Medialoco/sismo-la/docs/hackster-submission.md

# Hackster submission checklist (to stay within the rules)

**Published project:**  
https://www.hackster.io/thepriben/sismo-la-the-seismograph-that-learns-from-real-quakes-545685  
(11 September 2026 — Story, schematic, Things; contest submit still due **13 Sep 2026**.)

Summary of the rules to follow, based on the
[Content Guidelines](https://www.hackster.io/guidelines) and
[How to Create a High-Quality Project Tutorial](https://www.hackster.io/AlexWulff/how-to-create-a-high-quality-project-tutorial-e25feb).
We fill this page in as the project progresses.

## Contest requirements (reminder)

- Must use the **Arduino UNO Q** and **App Lab**.
- Target category: **Best Social Impact** (alt. Industrial IoT).
- Submission deadline: **September 13, 2026, 11:59 PM PDT**.
- Appreciated bonuses: sustainability, user experience, scalability, edge AI
  (Edge Impulse), cloud integration (Arduino Cloud / AWS).
- Two of those bonuses we do **not** have, and must not imply: there is no Edge
  Impulse model (the noise filter is an online logistic regression in
  `python/classifier.py`, still silent for want of a single labelled earthquake)
  and no Arduino Cloud or AWS integration (publishing goes straight to the
  GitHub contents API). Claiming either would be the one mistake this project
  cannot afford.

## Quality checklist (Content Guidelines)

- [x] **Name**: a complete sentence, describing *what it does*, catchy, no URL.
      (Not "Arduino UNO Q project" but e.g. "A neighborhood seismograph that
      learns from real Los Angeles earthquakes".) → drafted in
      `hackster-story.md` (name / pitch at the top of the video storyboard).
- [x] **Pitch**: a single sentence, does not duplicate the name, no URL.
      → drafted; shares no significant word with the name.
- [ ] **Cover image**: high resolution, good lighting, **no text**, shows the end
      result (not a tangle of breadboard wires). 4:3 format.
- [ ] **Difficulty**: accurate.
- [ ] **Categories**: max 3, describing what it *achieves* — avoid "Arduino",
      use e.g. "Monitoring", "Data collection", "Social impact".
- [ ] **Things**: list ALL components actually used (UNO Q, IMU…), with a store
      link when possible. Software/tools go in their own sections.
- [ ] **Story**: structured in steps with headings (not a wall of text),
      clickable URLs, embedded videos, **code as snippets** (not plain text),
      crisp images. Full paste-ready text: [`hackster-project-story.md`](hackster-project-story.md).
- [ ] **Schematics**: section reserved for schematics (Fritzing or other).
- [ ] **Code**: files in the Code section, correct language selected. No
      placeholders to inflate the checklist.
- [ ] **Language**: correct English, careful spelling/punctuation.

## Recommended Story structure (steps)

1. **The question** — ten million people on active faults, instrumentation that
   exists but is institutional, and the feasibility question that follows: can a
   $71–86 node — about $90 delivered — detect a quake and size it, unattended?
   (cf. MyShake, Raspberry
   Shake, whose cheapest board is $294.99.)
2. **The key idea: USGS calibration** — why a cheap sensor becomes useful when you
   have a free ground truth.
3. **Hardware & wiring** — UNO Q + IMU (photo + Fritzing schematic).
4. **The real-time MCU** — STA/LTA explained simply (snippet from the `.ino`).
5. **The Linux side (Dragonwing)** — WiFi, USGS feed, correlation (Python
   snippets).
6. **Detection vs confirmation** — the distinction the whole project rests on. A
   shake the trigger found by itself is a detection; a shake found because the
   catalog named the second is a confirmation. Say it before showing any result,
   because every result below is one or the other.
7. **The second channel: record first, search later** — the continuous envelope,
   and why knowing the second to examine is worth about one magnitude.
8. **The App Lab dashboard** — screenshots. Use the live one
   (`docs/images/dashboard-live.png`), not a replay still.
9. **Results in LA** — what there is, stated as it is:
   - two catalog-backed confirmations at frozen constants: `ci41540608`
     (M3.2, Ontario, 2 September 2026, z = 4.34) and `ci41545920`
     (M2.6, Inglewood, 12 September 2026, z = 4.21); neither fired the blind
     trigger;
   - of 19 catalog events scanned retrospectively, most were refused because
     the shaking they could deliver here was below the sensor's own noise;
   - zero autonomous detections, amplitude calibration 0 of 8, noise filter
     0 earthquakes against 10 789 noise samples. These zeros are published as
     they stand and are part of the result.
   There is **no calibration curve** to show. Do not promise one.
10. **How we would know it is broken** — the audit: every cataloged event
    classified out-of-reach, marginal, triggered, confirmed or
    should-have-been-seen. On **6 September 2026** that last count left zero: the
    station flagged an M3.2 as one it should have seen and did not, and published
    it against itself half an hour later. Reading the record shows nothing
    arrived; the prediction was on the optimistic side of a law that scatters by
    a factor of two. Lead with this. An instrument that reports its own failure
    unprompted is worth more than one that only ever reports successes, and it is
    the part of this build a judge cannot get from a datasheet.
    Tell the rest of the story, because it is the same argument twice over. On
    **9 September** USGS revised that earthquake to M3.07, which dropped the
    predicted shaking and **withdrew the miss** — a referee you do not control can
    take back what it gave you. The same week the retrospective channel crossed
    its threshold on an M2.33 whose expected shaking was **33x below the sensor's
    own noise**, i.e. a false confirmation, one day after we finished measuring
    that such crossings happen about **once in 55** on this station's own
    recordings. That crossing is **not** counted with the two confirmations
    above; the Story should say so in one sentence (the public page lists two
    accepted confirmations — Ontario and Inglewood — and treats the distant
    M2.3 crossing as a separate false-alarm case in the report). Nothing was
    retuned to hide either event: the thresholds have been frozen since
    1 September, and being able to state the error rate is the result.
11. **Limits, and what the measurement makes possible** — a neighborhood
    strong-motion node, not a teleseismic instrument: 96.9 % of the local catalog
    is out of reach of both channels, and one station gives a ring, not a pin.
    Do not stop there, and do not present that as a negative result. It is the
    first measured sensitivity for this class of hardware, and it is exactly the
    number a network has to be sized on. Fifty nodes is about **$4,000**, and
    fifty changes the problem rather than merely repeating it: household noise is
    what drowns the signal and it is strictly local, where an earthquake reaches
    every neighbour within seconds, so requiring two nodes to agree removes most
    of that noise and lets the threshold come **down**. Coverage stops being a
    weakness too — every point gets the sensitivity of its nearest sensor instead
    of the average one, a gain that costs nothing but geometry. With synchronised
    clocks the arrival times cross and give an epicentre, and many amplitude
    readings give a map of what was actually felt, which is the only thing anyone
    needs in the first minutes. State the reservation in the same breath: none of
    it is built, the microcontroller's clock drifts 1 099 ppm, and at fifty sites
    the hardware stops being the expensive part. Figures from §12 of the report.
12. **Everything here is checkable** — close on this rather than on a promise.
    The technical report is deposited, in English and French, with an archive that
    reproduces every quoted number from the raw recordings:
    **[10.5281/zenodo.22679543](https://doi.org/10.5281/zenodo.22679543)**. The
    code is at <https://github.com/Medialoco/sismo-la>, tagged **v1.0.0** for this
    report, and the live page is <https://medialoco.github.io/sismo-la/>. A judge
    can check any figure in the Story without taking our word for it, which is the
    whole argument of the build and is worth saying plainly.

## Writing & photo tips (Wulff tutorial)

- Lots of **photos** (close-ups, plenty of light, consistent angle).
- Take **more photos than you think you need** during the build.
- Schematics via **Fritzing / CAD**, no napkin sketch.
- **Commented** code, named values (no magic numbers), consistent whitespace.
- **Short, varied** sentences; mix technical / accessible; zero typos.
- A GIF works as a cover (motion = clicks), but at reduced resolution.

## Media to produce (to check)

- [ ] **Cover photo** (final result, polished). Needs the camera, and the rules
      say **no text** on it — so no dashboard export can serve as the cover,
      it has to be the physical station. `docs/images/cover-concept.png` is a
      *rendered concept*, not this station: the board is lit, the screen behind
      shows a map with concentric rings the project cannot produce, and it is
      1536x1024 (3:2) where the guidelines ask 4:3. A project whose whole claim
      is that its numbers are real should not open on a render. Shoot the actual
      station — `docs/images/station.png` (1024x576, 4 September) is the framing
      to beat, taken in better light and cropped to 4:3.
- [ ] Macro photo of the UNO Q + IMU assembly.
- [x] Schematic — `docs/images/wiring.png` (and `.jpg`), source `wiring.svg`.
      Not Fritzing: there is nothing to breadboard, so it shows the single
      Qwiic link and the signal path instead, and prints the one trap worth
      printing (the Qwiic port is `Wire1`, not `Wire`).
- [ ] GIF/video of a detection (tap the desk -> trigger).
- [x] Dashboard screenshot — `docs/images/dashboard-live.png`, the operator
      dashboard on live data (light theme, station coordinates replaced by a
      placeholder). `dashboard-1920x1080.jpg` fills a 16:9 slot (padded, nothing
      cropped).
- [x] Screenshot of the real confirmation — `docs/images/public-map-confirmed.png`
      and `public-data-confirmed.png`, taken from the live published pages while
      `ci41540608` was still inside `publish.window_days`. Caption it
      **confirmed**, never *detected*.
- [x] Diagram of the principle — `docs/images/how-it-works.png` (and `.jpg`).
      Source is `how-it-works.svg`: plain text, edit it rather than the raster.
- [x] Diagram of the network geometry — `docs/images/network.png` (and `.jpg`),
      source `network.svg`. Caption like the README: *One station yields a ring;
      three rings intersect* — not a live map.
- [x] Calibration sequence — four stills cut from the timelapse,
      `timelapse-1-learning` to `timelapse-4-calibrated`, usable as a
      before/after pair in the Story. **These are replay, not measurement**:
      real catalog times, synthetic amplitudes about 38 times too large so the
      demo crosses the trigger. The caption has to say so in the same frame, and
      `timelapse-4-calibrated` in particular shows a calibrated state the station
      has never reached. It illustrates the software; it is not evidence.
