Medialoco/sismo-la/docs/video-script.md

# Contest video — pointer

The shot list, voice-over, and definitions live in
[`hackster-story.md`](hackster-story.md). Cut from that file.

`docs/video/narration.srt` follows the **Say** lines in that file. Timings are
a first cut (~3 min); nudge them after picture lock.
