Medialoco/sismo-la/docs/images/dashboard-1920x1080.jpg

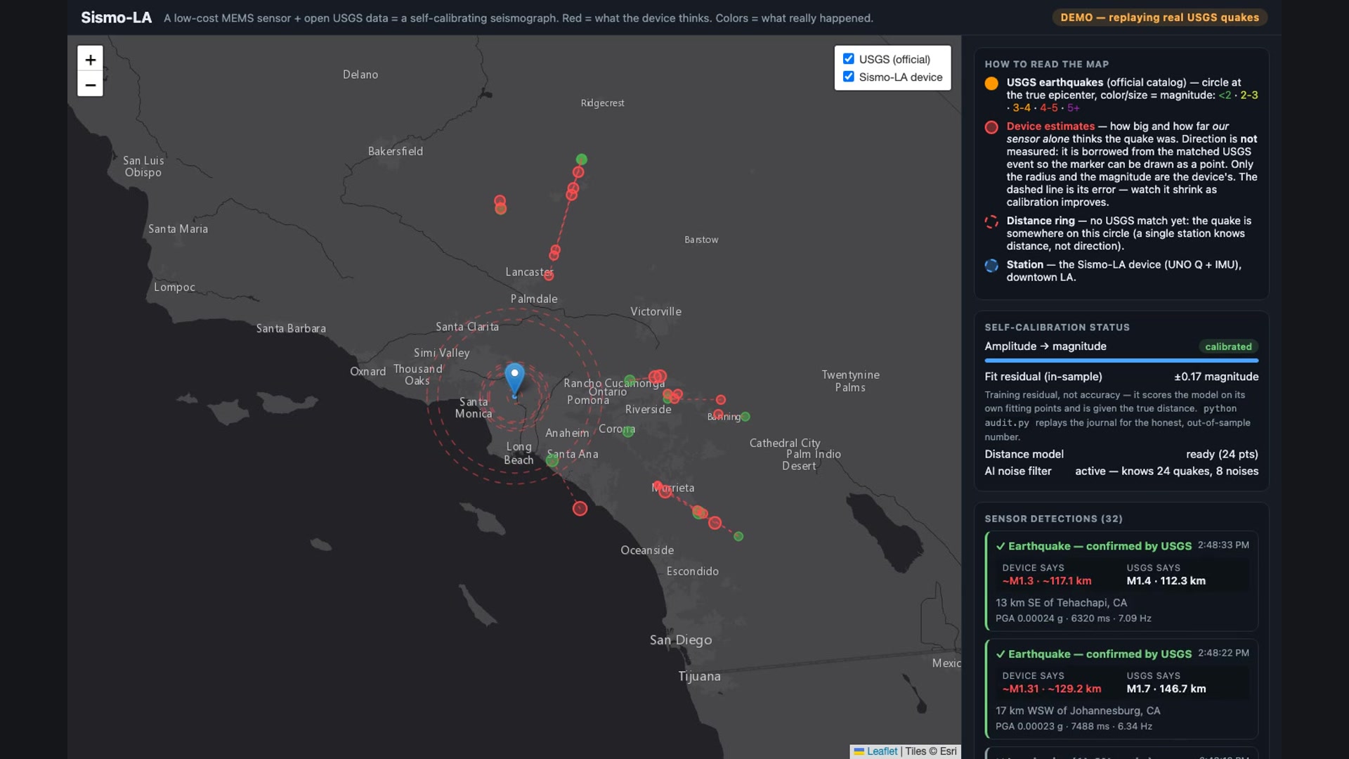
docs/images/dashboard-1920x1080.jpg
