Medialoco/sismo-la/docs/images/how-it-works.jpg

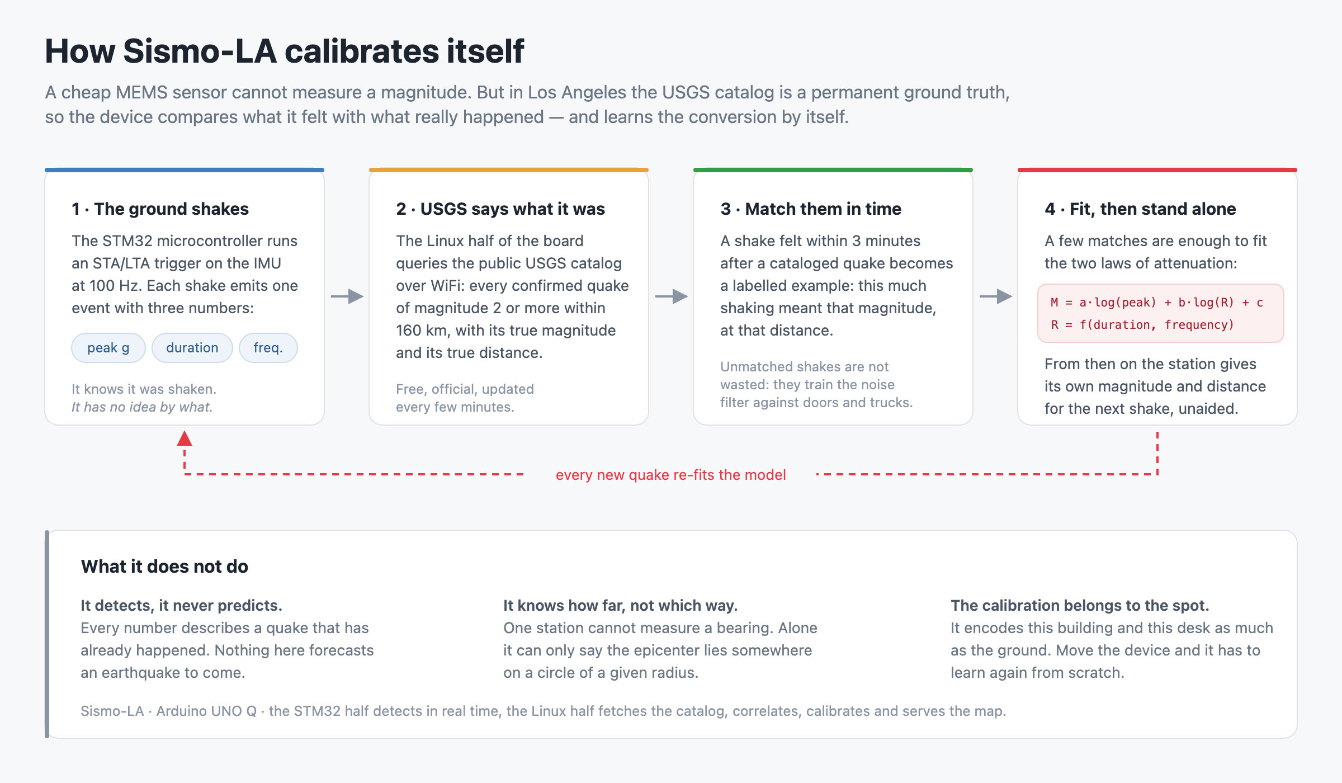
docs/images/how-it-works.jpg
