Medialoco/sismo-la/docs/images/public-data-confirmed.png

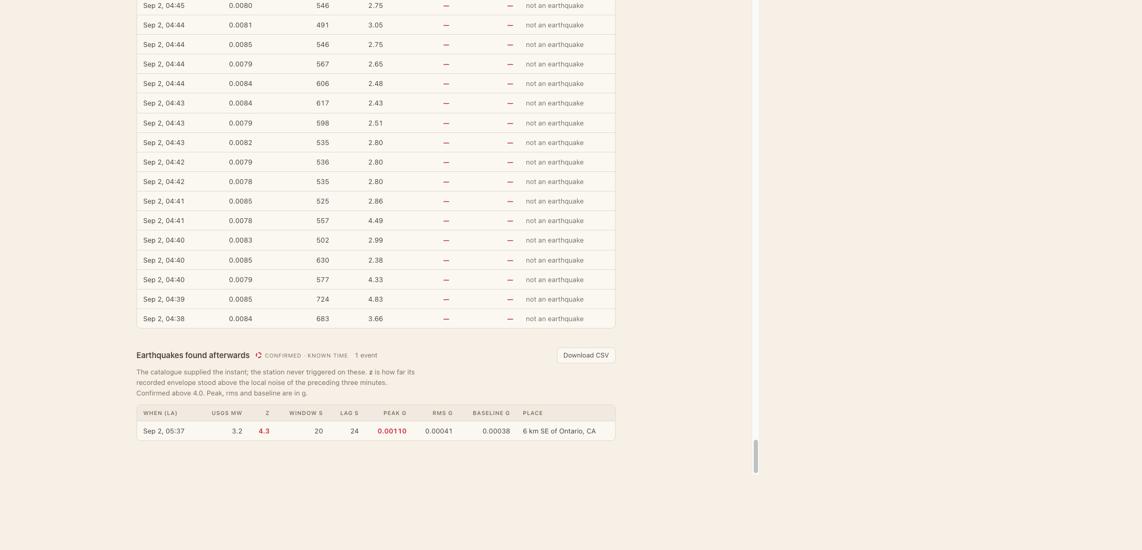
docs/images/public-data-confirmed.png
