Medialoco/sismo-la/docs/images/public-map-confirmed.png

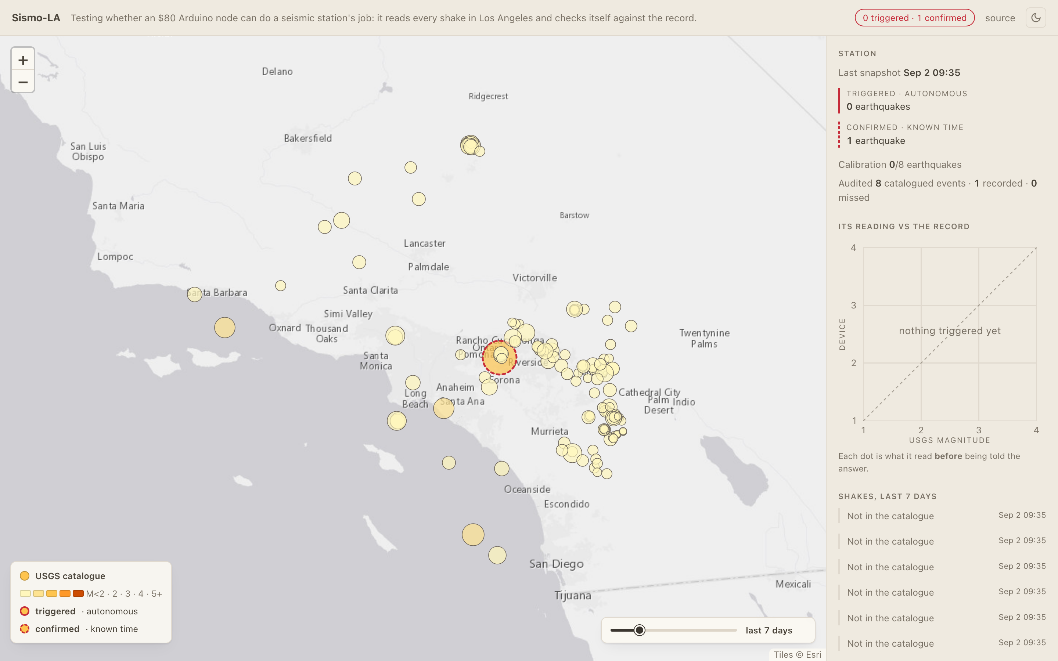
docs/images/public-map-confirmed.png
