Medialoco/sismo-la/docs/images/station-cover-4x3.jpg

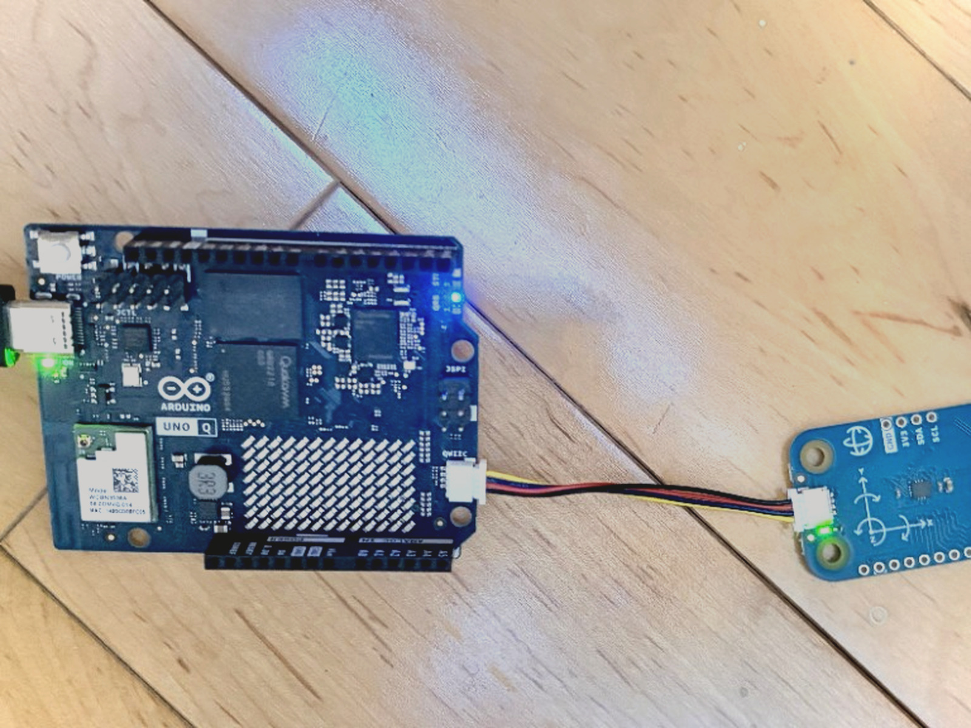
docs/images/station-cover-4x3.jpg
