Medialoco/sismo-la/docs/images/station-cover-branded.jpg

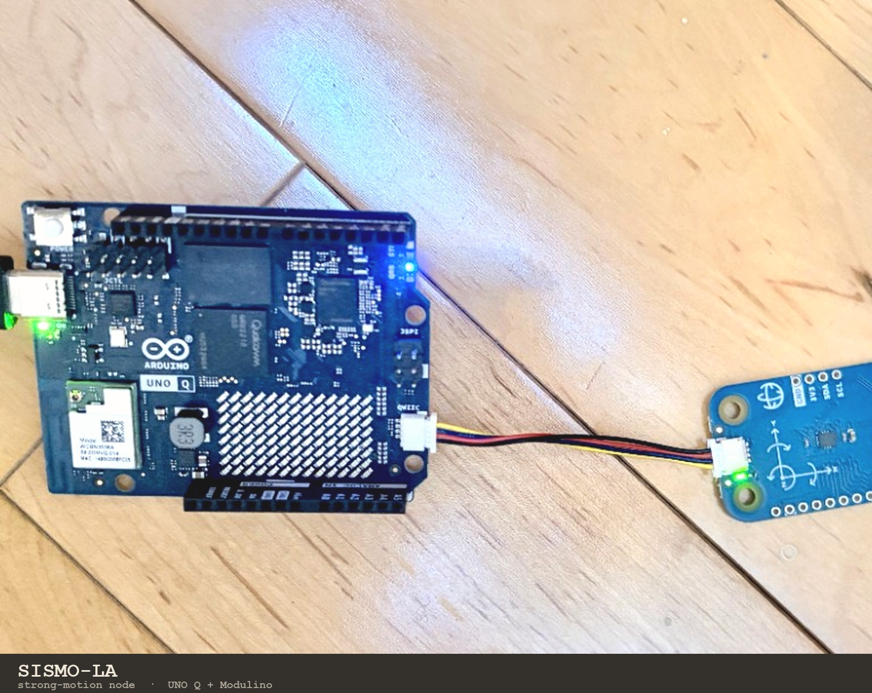
docs/images/station-cover-branded.jpg
