Medialoco/sismo-la/docs/images/timelapse-1-learning.jpg

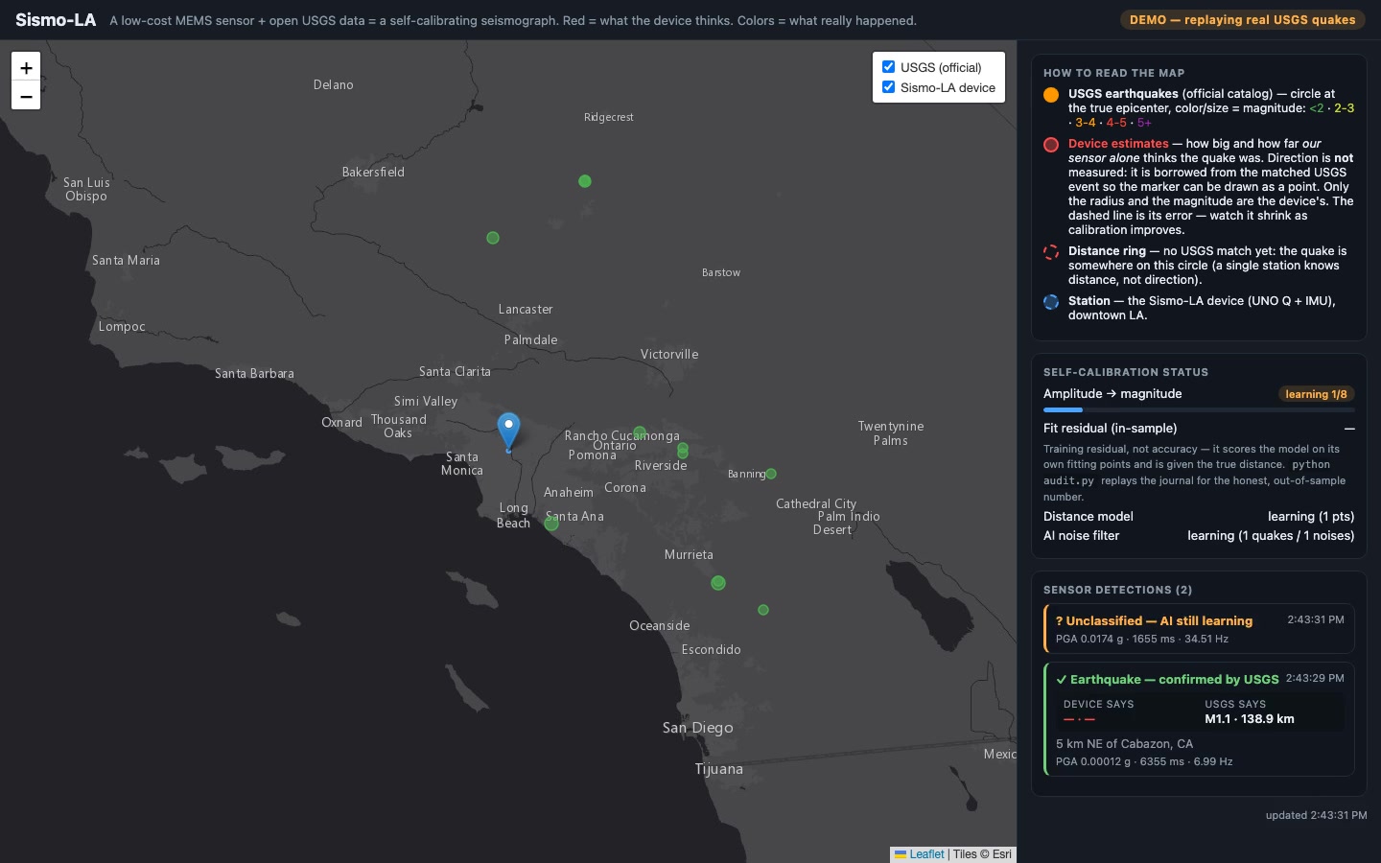
docs/images/timelapse-1-learning.jpg
