Medialoco/sismo-la/(commit log)

2026-06-21 Initial scaffold: Sismo-LA low-cost seismograph for the UNO Q contest
    - Concept, architecture and USGS-based calibration docs (FR)
    - MCU sketch (STM32): STA/LTA event detection on LSM6DSOX IMU
    - Linux app (MPU): USGS catalog client, calibration model, correlation loop
    with a --mock mode for hardware-free development
    - App Lab manifest skeleton + web dashboard placeholder
    - Hackster submission checklist to follow contest guidelines
2026-06-21 Add hardware doc: bill of materials and wiring
2026-06-21 Drop price column from the bill of materials
2026-06-21 firmware: note Qwiic is on Wire1 for the UNO Q
2026-07-04 Add web dashboard, AI noise filter, distance model and replay demo mode
    - app/server.py + app/dashboard/: Leaflet map overlaying the USGS catalog
    (ground truth) with the device's own estimates in red (epicenter +
    magnitude), error vector between the two, live comparison panel.
    - app/classifier.py: online logistic regression earthquake-vs-noise, labels
    harvested automatically from USGS correlation.
    - app/calibration.py: DistanceModel (duration+frequency -> epicentral
    distance) enabling standalone (distance, magnitude) estimates.
    - Replay mode (--replay): replays the recent USGS catalog as synthetic
    detections for demos/video.
    - Correlation threshold lowered to M2.0; startup USGS che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
    [calibration.py, classifier.py, main.py, seismo_mcu.ino]
2026-07-04 Polish repo for submission: rewrite README, add Hackster story draft
    - README: hero screenshot, three-models table, UNO Q gotchas, replay-first
    quick start, accurate layout and status.
    - docs/hackster-story.md: full English submission draft (name, pitch, story
    in 9 steps, media checklist).
    - docs/images/: dashboard screenshot; app.yaml points to server.py; drop the
    stale web/ placeholder; gitignore runtime state files.
2026-07-04 Add autonomous publishing: remote snapshot upload + static public page
    - server.py: publisher thread pushes the station JSON every minute via
    HTTP POST, atomic file write, or an arbitrary upload command (scp/curl).
    - web-remote/sismo.html: fully static page for any host (e.g. next to
    tools/quakes.html) overlaying station.json on the live USGS map;
    degrades to USGS-only when the station is offline.
    - config example + docs: publish block, autonomous-mode section.
2026-07-05 Wire live MCU->Linux path: Monitor source + firmware heartbeat
    - Board OS upgraded (arduino-router 0.1.12 -> 0.9.0): Bridge Monitor now
    works end-to-end; heartbeat JSON confirmed flowing every 10 s.
    - firmware: 10 s heartbeat with live STA/LTA ratio to prove the link.
    - app: new "monitor" source type consuming `arduino-app-cli monitor`
    (adb-wrapped from a dev Mac, direct on the board), skips heartbeats.
    [main.py, seismo_mcu.ino]
2026-08-31 State claims honestly: replay validates the pipeline, not the sensor
    Replay mode synthesizes sensor readings from cataloged magnitude and distance
    through an attenuation law, then the calibration fits the inverse of that same
    law, so the replay RMSE largely recovers the noise the generator injected. It
    validates the software, not the instrument.
    The README now states the boundaries up front: the device detects rather than
    predicts, loses azimuth when offline, and is calibrated for one spot only.
2026-08-31 Fix dominant-frequency bug and ground all claims in measured data
    The MCU compared the sign of the centered previous sample against the raw
    current one. Since `dyn` is a vector magnitude and never negative, the test
    degenerated to `prevCentered < 0` and dom_hz collapsed to roughly 25 Hz for
    every event, gutting the frequency feature that both the distance model and
    the noise filter depend on. Replay hid this by synthesizing dom_hz from an
    analytic formula instead of running the firmware. Also seeds the STA/LTA from
    the first reading and warms up for a full LTA window, so the boot no longer
    produces a burst of false triggers.
    Removes two presentation overclaims. The red marker on the map bor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
    [seismo_mcu.ino]
2026-08-31 Restructure as a real App Lab App
    The contest requires App Lab, but the repo could not have run under it. App
    Lab resolves an App by convention - app.yaml at the root, python/main.py for
    the MPU half, sketch/sketch.ino plus sketch/sketch.yaml for the MCU half -
    and none of those paths existed. app.yaml was also a hand-invented schema
    with python:/sketch:/bricks:[web,ai] keys that App Lab does not read, and
    sketch.yaml was absent entirely, which makes `arduino-app-cli app start`
    fail with "sketch has no default profile".
    Moves app/ to python/ and firmware/seismo_mcu/ to sketch/, renames server.py
    to main.py as the entry point and the old headless main.py to pipeline.py,
    rewrites app.yaml aga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
    [calibration.py, classifier.py, main.py, pipeline.py, sketch.ino]
2026-08-31 Run the App on the board: switch MCU->Linux to the Bridge RPC link
    App Lab runs the Python half in a container, where arduino-app-cli does not
    exist: the previous transport (spawning `arduino-app-cli monitor` as a
    subprocess) could never work on the board. The router socket is bind-mounted
    there, so the sketch now sends one `seismic_event` notification per detection
    and Python receives it via Bridge.provide, as Arduino's own examples do.
    Also confirmed on hardware that the dom_hz sign-test fix holds: three real
    taps gave 2.57 / 4.99 / 10.60 Hz, where the value used to sit near 25 Hz
    whatever the signal.
    - report MCU status and noise floor over the same link, so a dead I2C bus no
    longer l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
    [main.py, pipeline.py, sketch.ino]
2026-08-31 Journal every detection so the calibration can be replayed and graded honestly
    The RMSE the dashboard reports is a training residual: it scores the model on
    the very points it was fitted on, and it is handed each quake's true catalog
    distance, which a deployed station does not have. Nothing in the repo could
    tell you how much that flatters it.
    Every detection is now appended to event_log.jsonl together with what each
    model predicted *before* learning it, so audit.py can replay the journal and
    report prequential, out-of-sample residuals on the operational chain
    (duration and frequency -> distance -> magnitude).
    The first answer it gave was a trap worth recording. On an 11-match run the
    oper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
2026-08-31 Publish the station on the public quakes page and survive a reboot
    The live tools/quakes.html renders every basemap tile stamped "API KEY
    REQUIRED": Carto closed anonymous access to its raster tiles. Move to the
    keyless Esri Gray Canvas, light or dark following the site theme, with the
    label tiles in their own pane so place names no longer cover the data.
    The page now also draws the station's last three estimates next to the USGS
    circles, reading a station.json published beside it. A missing or unreachable
    snapshot degrades to the USGS layer alone, so the page never depends on the
    board being up. Popups spell out that a lone station measures a distance and a
    magnitude but never a direction.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
2026-08-31 Keep the station alive across reboots and cut contest stills
    The board has no autostart and the sudo password needed for a systemd unit is
    lost, so install-autostart.sh does the job with the rights the arduino user
    already has: it belongs to the docker group and cron is running. Docker brings
    the container back, and a @reboot entry rebuilds it through app-cli if it was
    removed. Two caveats worth remembering are written down in AGENTS.md: app
    restart recreates the container and drops the Docker policy, and Docker
    ignores that policy after a manual stop or kill, so killing the container
    proves nothing.
    Also cut four stills from the calibration timelapse plus a 1920x1080 cover,
    padded rather t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
2026-09-01 Explain the principle in one diagram
    The README opened on a wall of text and a dashboard screenshot that only makes
    sense once you already understand the idea. Add a diagram that carries it on
    its own: measure a shake, ask the catalog what it really was, match the two,
    fit, then stand alone -- with the feedback loop drawn explicitly.
    Half of it is given to what the device does not do, because that is where a
    project like this loses its credibility: it detects and never predicts, it
    knows a distance but no direction, and its calibration belongs to the spot it
    was learnt in.
    Source is SVG so the wording stays editable for the contest entry. Also flag
    in the submission checklist that no dashb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
2026-09-01 Put the diagram in the story draft and mark the media that exist
    The story explained the calibration loop in prose before showing anything, so
    lead section 2 with the diagram. Tick off the media already produced, and note
    on the correlated-event screenshot that it comes from replayed catalog data.
2026-09-01 Draw the build instead of describing it
    The Schematics section had nothing in it, and a Fritzing diagram would be
    misleading here: there is no breadboard and no jumper wire, just one Qwiic
    cable. So the schematic shows what actually matters -- the single link, the
    four conductors it carries, the split between the microcontroller that must
    never miss a sample and the Linux side that does everything that can wait,
    and the path a shake takes from the desk to the dashboard.
    It also prints the one trap that costs an afternoon: on the UNO Q the Qwiic
    port sits on Wire1, not on the default Wire bus.
2026-09-01 Lead the entry with what the device does, not with its codename
    The title opened on "Sismo-LA", a name that means nothing to a juror scanning
    a list, and the pitch repeated the title instead of adding to it. Rewrite both
    so the first line states the behaviour and the pitch states the problem it
    solves, keeping the alternates in the draft. Neither claims a forecast.
2026-09-01 Strip the public page down to the comparison that matters
    The page had grown a panel full of model internals and explanatory prose that
    buried the one thing a visitor should see: what the catalogue recorded, and
    what the device made of it. Two layers now, a floating legend at the bottom
    left instead of a column of text, and a list where each row puts the device's
    reading straight above the USGS one.
    Publishing drops to one push every half hour. Each snapshot carries the recent
    detections, so a slower interval delays them without losing any, and the
    commit history of the page stays readable.
2026-09-01 Publish the station without publishing where it is
    A single station measures a distance, never a bearing. The red epicenter
    marker only landed somewhere because it borrowed the direction from the very
    event it was meant to be estimating, which made the most eye-catching thing on
    the public page the least honest one.
    Coordinates now stay out of the snapshot entirely. The catalogued events the
    station recognised get a red outline and carry its reading in the popup, and a
    scatter puts the magnitude it read against the magnitude the USGS published,
    against the y = x line. That is what the device actually produces, and none of
    it needs an address. The local dashboard, on the operator's own netwo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
2026-09-01 Publish the whole record, not just what is still in memory
    The scatter was built from the in-memory detection list, a short deque that
    starts empty on every restart. A station meant to run for months would have
    shown a handful of recent dots and forgotten the rest.
    Snapshots now carry a history rebuilt from the journal, which is the thing that
    actually accumulates. It reports the estimate each model made before that
    earthquake was folded into it, so the dots are out-of-sample rather than the
    training residual the dashboard quotes about itself; replay matches stay
    excluded, same guard as audit.py.
    Publishing also stops committing when nothing happened. Only detections,
    history and model sta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
    [eventlog.py, main.py]
2026-09-01 Give the station a way to actually hold the publishing token
    No device data had ever reached the page, and the token was only the last of
    three missing links. The board has no config.yaml at all, so it falls back to
    the example where publishing is off and the publisher thread never starts; the
    startup log shows no "publisher on" line, which is the way to tell.
    The third link had no solution yet. App Lab builds the container's compose file
    from app.yaml, which has no field for environment variables, and regenerates it
    on every start, so a secret cannot travel through the environment. The app
    folder is bind-mounted at /app, so the token travels as a file beside the code
    instead. It is gitigno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
2026-09-01 Record the power requirement and the loss of shell access off USB
    The BOM said "PD recommended" for the supply, which understates it: Arduino
    asks for 5 V at 3 A and warns of undervoltage during wireless bursts, with a
    reset below 4.5 V. A 10 W phone charger boots the board and then reboots it at
    random, which reads as a software crash and would be blamed on the code.
    Also noted that ssh is inactive on the board and enabling it needs root we do
    not have, so once it is off USB the only remote surface is the dashboard. Any
    change needing file access has to happen while ADB is connected.
2026-09-01 Add a rolling week on the map and a page for the numbers
    The map showed the last twelve catalogued events, which said nothing about how
    often Los Angeles actually shakes. It now covers a rolling week, the station
    publishes its window alongside the data so both agree, and the panel list is
    rebuilt from the journal rather than the fifty-entry deque that restarts empty.
    The calibration record deliberately stays outside that window: it is the one
    thing that should accumulate.
    data.html holds what a map cannot show — the full record with signed errors,
    and every shake of the week including the ones that were a door or a truck,
    which is most of them and is exactly what the noise filter learns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
    [eventlog.py, main.py]
2026-09-01 Let the visitor choose how far back the map looks
    A fixed week was an arbitrary choice made for the visitor. The map now carries
    a slider from a day to a month, remembered between visits, and the station
    publishes the wider window so narrowing it costs nothing.
    Its maximum follows what the station actually published, so the catalogue and
    the device layer always cover the same period rather than showing a month of
    one against a week of the other. Dragging redraws from data already in hand;
    only releasing the slider spends a request.
    [eventlog.py, main.py]
2026-09-01 Find why autostart never fired: the account password is expired
    The @reboot entry was not slow or racing the daemon, it never ran. cron's
    journal shows PAM refusing the job outright because the arduino account's
    password has expired, which is also why sudo fails on this board. The missing
    boot log was the tell: a job that ran and failed would still have created it.
    So the Docker restart policy is not a backup here, it is the only mechanism
    that works, since dockerd starts as root and never consults PAM. The install
    script now says so, warns when it detects the expired account rather than
    reporting success, and points out that every deploy silently removes the
    policy by recreating the contai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
2026-09-01 Stop the station from failing silently when the MCU goes quiet
    The station served a live-looking dashboard for 24 minutes with a dead
    sensor. Three defects stacked: the MCU was not running, that froze the
    whole pipeline, and nothing said so.
    The USGS refresh lived inside the loop over MCU events, which blocks on
    an empty queue forever, so a silent MCU stopped the catalog fetch and
    froze `updated` at its start-up value. Move the refresh to its own
    thread and let a heartbeat mark the state fresh, so `updated` measures
    the station being alive rather than the sensor delivering shakes.
    Publish a health block (MCU silence, catalog age, restart count) and
    show it: a red banner on the dashboard, a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
    [main.py, pipeline.py, sketch.ino]
2026-09-01 Recover the MCU on boot, surface staleness, fix the station position
    The station came back from a power cut looking alive and being blind: the
    watchdog only did `docker start`, which revives the dashboard while App Lab's
    stop leaves the microcontroller halted. It now recovers through the App Lab
    daemon so the sketch is reflashed too, and judges success by the container's
    state rather than by scanning the flasher's chatter for the word "error".
    Nothing said any of this out loud, so a dead sensor read as a healthy station.
    USGS polling moves to its own supervised thread instead of living inside the
    event loop, both loops restart with backoff instead of dying silently, and the
    snapshot carries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
2026-09-01 Post-mortem of the second power cut, and re-anchor the reference GMPE
    The outage was not a reboot: the board lost power at 00:45 local and stayed
    dead until 06:28, so the night's noise measurement is gone. Two findings worth
    keeping. The MCU comes back on its own after a power cut, running the sketch
    already in flash, so the gap is specific to `app stop` rather than to reboots.
    And the dashboard looked dead at 06:30 because that was boot + 72 s, against
    the watchdog's 150 s wait. The App Lab recovery path was not yet on the board,
    so this cut did not test it.
    Two clock traps documented: the board has no RTC battery, so journald
    timestamps inside a boot are wrong until NTP lands and boot ord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
    [pipeline.py]
2026-09-01 Show the station's state instead of narrating it
    The staleness warning added this morning explained itself in a sentence — "No
    snapshot for 5.7 hours, the station is probably offline" — where the header
    badge already had room for it. Freshness now lives there, `offline · 6 h` or
    `degraded`, filled red, on the same two triggers; data.html had no freshness
    signal at all and gets the same badge, hidden while the tables are current.
    The rest is the same pass over text that repeats what is already on screen: the
    three-sentence chart caption, "still learning", and the "traffic, a door, a
    footstep" line that appeared under every unmatched shake. Unmatched rows are one
    line now, which leaves t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
2026-09-01 Measure the detection threshold, and narrow the anti-alias filter
    The firmware has no absolute g threshold, so the floor in g is whatever the
    ambient level is. Measured on real quiet windows at the final location: the
    noise floor barely moved off the desk (0.00087 -> 0.00066 g) while the trigger
    rate collapsed (22.6 -> 3.2/h), so the rate is the observable the user should
    watch, not the floor. The smallest PGA that has ever fired is 0.0034 g, about
    five times the quiet median.
    Crossed with 2184 real Burbank events, that floor gives 1.3 to 6.6 genuine
    detections a year depending on site amplification, a 56 to 279 day wait for the
    first one, and a 4 to 19% chance before the contest deadline.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
    [sketch.ino]
2026-09-01 Reframe the project as a feasibility question and price the node honestly
    Lead with whether a neighborhood could run its own seismic network, whose
    prerequisite is a cheap node that detects and sizes a quake unattended, and
    report how far the station gets: autonomy done, 0/8 calibration, detection
    threshold measured. Replace the unsubstantiated $25 node with sourced,
    dated prices ($71-86, $75-90 delivered) in the bill of materials.
2026-09-01 Trigger on a 0.7-12 Hz band and measure what it is worth
    The detector ran STA/LTA on the raw vector magnitude, so every bit of noise
    outside the band an earthquake occupies was raising the denominator for
    nothing. Two one-pole high-pass sections at 0.7 Hz and two low-pass at 12 Hz,
    per axis, with every coefficient derived from the sample rate the loop really
    achieves (95.3 Hz, not the nominal 100) and the passband normalised so pga_g
    stays in g.
    pga_g is now the band-passed peak: it is the amplitude that crossed the
    trigger and the one the amplitude model should learn from. That breaks
    comparability with the 255 earlier records, which is acceptable because all of
    them are unmatched noise an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
    [eventlog.py, pipeline.py, sketch.ino]
2026-09-01 Survey which quieter accelerometers actually plug into an UNO Q
    The noise floor is now known to be the LSM6DSOX's own electrical noise, so the
    next gain is hardware. Prices out the candidates against the constraint the
    user actually has -- pluggable boards, no circuit design -- and quantifies each
    one through the same catalog convolution that produced the published rates.
    tools/sensor-gain.py reproduces 1.31-6.56 and 1.98-9.79 det/year against the
    1.31-6.57 and 1.98-9.80 in AGENTS.md before being trusted with a new sensor.
    The ADXL355 is the only candidate that changes the answer (22.5 ug/rtHz at
    +-2 g, 6x the detection rate) and its library was checked by building it for
    arduino:zephyr:un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
2026-09-01 Correct the sensor survey against the three follow-up reads
    The cover-page 37 ug/rtHz on the SCA3300 is not in the specification table
    (44 in mode 1, 35 in 3/4). The KX134 is 300 ug/rtHz in the ROHM datasheet,
    not the 130 SparkFun quotes -- that number is the KX132, also louder than
    the LSM6DSOX. The ADXL357 is 75 at +-10 g (Rev. A).
    Two parts the first pass missed: the SparkFun ISM330DHCX Qwiic (60 ug/rtHz,
    $25.50, in stock, the only quieter board that actually plugs in) and the
    IIS2ICLX (15 ug/rtHz, 2-axis, no board in stock anywhere). The PMDZ header
    is already soldered -- ADI's own product photo -- so that is the ADXL355
    to order, in SPI, after the contest.
    The geophone arithmetic is n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
2026-09-01 Study the mechanical route out of the sensor noise floor
    The at-rest floor is the LSM6DSOX's own electrical noise, so amplifying
    ground motion before the sensor is the one gain that does not lift the
    noise with it. Quantify what that is actually worth.
    A resonance multiplies a broadband wavetrain by sqrt(1 + (pi/2) f0 Q /
    ENBW), not by Q: 5.0 at Q=20 and 4 Hz, 3.3 after the single-axis
    haircut, and saturating at 1/r once it amplifies the site's own noise.
    r has never been measured and the floor bounds it only at r < 0.5,
    where the whole scheme is worth 1.4x. The free lever is larger than the
    built one: a low-rise timber building is a 4-9 Hz resonator worth 3.4x
    by the same formula, 3.93x by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
2026-09-01 Search the recorded envelope at the arrival time the catalog implies
    The blind STA/LTA tests ~170k windows a day, and that false-alarm budget,
    not the noise floor, is what sets its threshold. The USGS publishes an
    origin time for every earthquake, so the station now records a continuous
    envelope (one peak and one rms per second, band-passed) and re-reads it at
    the computed arrival instead of only waiting to trigger. A handful of
    windows per event buys the same confidence far closer to the noise:
    measured x7.4 in amplitude, +1.00 Mw, taking the odds of feeling a real
    earthquake before 13 September from 6-28% to 28-70%.
    Each batch is dated on arrival from the NTP-synced host clock; the MCU
    os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
    [audit.py, envelope.py, eventlog.py, main.py, pipeline.py]
2026-09-01 Record how to probe the retrospective search on the live envelope
2026-09-02 Audit the catalog against what the station actually felt
    An absence of detection was mute: nothing distinguished "too small for
    us" from "we missed something within reach", which is a fault. For every
    cataloged event the station now sets a predicted amplitude (the refit
    reference law) against the noise it measured in its own envelope at the
    computed arrival instant, converts the law's 0.39 log10 scatter into a
    detection probability over the x1-x4 site range, and compares the result
    with the journal and the retrospective findings.
    The trigger floor is scaled by the measured local noise rather than
    assumed, because STA/LTA has no absolute threshold in g; the scale comes
    from the smallest peak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
    [expected.py, main.py]
2026-09-02 Take the station position from the station, not from a placeholder
    The position is deliberately absent from this repository, so the config
    loader fell back to the example -- a neutral downtown placeholder 15 km
    from the real site. --verify then audited a different station and
    reported a 25% drift as a MISMATCH, which reads as a broken constant
    rather than a broken centre. Every figure this tool prints is an
    epicentral distance under the skin, so that is not an approximate answer.
    --station-from reads the position off a running station's /api/state,
    which is the operator surface on the local network and is not stripped;
    --from-api prefers the snapshot's own station block; and the placeholder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
2026-09-02 Report the first confirmed earthquake, and keep its distance unpublished
    The retrospective channel found a real earthquake within a day of going
    live: M3.2 near Ontario, 68.8 km away, standing 4.34 local dispersions
    above the noise at the arrival instant the catalog implies. The blind
    trigger did not fire and needed about three times the amplitude, so the
    README, the story and the getting-started guide say "confirmed" and never
    "detected", and the calibration counter deliberately does not move.
    The confirmation also leaked a position. Its epicentral distance is not
    something the station measured -- it is computed from the station's own
    coordinates -- so one row draws a circle through the st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
    [main.py]
2026-09-02 Reach the station over WiFi instead of only over USB
    adbd runs unprivileged here and refuses adb tcpip, so there was no route
    to the board once it left the desk, and every Python change cost a trip
    to unplug it -- which reboots it, and a reboot can leave the MCU silent.
    Root came from the docker group all along: dockerd runs as root, and
    --user 0:0 overrides the image's pinned non-root user, which is what an
    earlier attempt at this was missing. enable-ssh.sh turns on key-only sshd
    and clears the forced password change that made PAM refuse every
    non-interactive session. push.sh deploys tracked files only and waits on
    the MCU heartbeat rather than the HTTP server. reset-mcu.sh restarts the
    ro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
2026-09-02 Show the catalog's current magnitude for a confirmation
    The USGS revises a magnitude in the hours after an event: the first
    confirmation was journalled preliminary at M3.4 and the catalog settled
    at M3.2, so the public table disagreed with every document describing the
    same earthquake, including the video narration.
    The journal stays append-only -- it records what the station knew at the
    time, which is what makes out-of-sample scoring honest. Only the display
    is reconciled, from the catalog block refetched minutes earlier, the same
    way the map redraws the USGS layer on every poll instead of replaying it.
    history is left alone on purpose: there the catalog magnitude is the
    reference a device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
2026-09-04 Add a city-scale San Fernando pin and a roster for more stations.
    The public page names the first node without publishing the house, and a
    second kit is another row in stations.json plus its own snapshot file.
2026-09-04 Hide the calibration scatter until a trigger is matched, and announce the paper.
    The panel plot could only draw an empty 1-4 grid: no autonomous detection has
    ever been matched, and retrospective confirmations are deliberately excluded
    from it. Wrap it in a hidden container that drawChart() reveals on the first
    matched trigger, so it returns on its own.
    Both READMEs gain a section for the article due 12 September; the DOI is still
    to fill in. Drop the leftover refutation of an earlier per-node cost figure
    from the hardware, mechanical-gain and contest-story notes.
2026-09-04 Keep the audit counts machine-readable instead of drawing them on the page.
    Skimmed, "7 examined - 2 recorded - 0 missed" reads as a score of 2 out of 7,
    which inverts what the middle count means: how many of the seven the station
    could check at all. The calibration progress reads the same way. Both stay
    published in station.json, under expected.summary and calibration, and a
    non-zero missed still takes over the status badge -- so the page falls silent
    only when the audit finds nothing to say.
    Both READMEs and the audit method note now point at the snapshot rather than at
    the page.
2026-09-05 Light dashboard, a current screenshot, and a network diagram that is a diagram.
    The operator dashboard was hardcoded dark. Give it a light palette, with darker
    accents so a pending orange stays legible against white, and switch the Esri
    basemap from World_Dark_Gray to World_Light_Gray. Six dark hexes that had
    escaped the variables become --sunken and --hover.
    Replace the replay screenshot with a live one. The old one advertised a
    calibrated station with 27 distance points and 27 known quakes, all synthetic;
    the new one shows what the models actually hold -- 0 of 8, 0 points, 0 quakes
    against 4027 noises -- and the station's own audit, 6 examined, 2 recorded, 0
    unseen within reach. Its map p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
2026-09-06 Remove claims the code does not support from the docs
    No Edge Impulse model runs anywhere: the earthquake-vs-noise filter is the
    online logistic regression in python/classifier.py, three features, silent
    until it has three examples of each class, and it still has 0 quakes against
    4027 noise samples. architecture.md announced it as deployed and
    calibration.md spoke of its training set; both also gave the correlation
    threshold as M3 where usgs.min_magnitude is 2.0.
    The contest submission plan promised a calibration curve that does not exist
    and pointed the "successful USGS correlation" screenshot at a replay still
    whose amplitudes are 38x too large and whose calibrated state the station has
    n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
2026-09-06 Keep the audit counts out of the public pages entirely
    Three presentations were tried and all three misled. The status badge made
    a working audit and a silently dead sensor identical, since a filled red
    badge reads as a broken device. A captioned line, and then all three counts
    defined one by one on the data page, still required reading a paragraph
    before a bare integer stopped misleading a visitor.
    So neither page draws any of it. The counts stay complete and timestamped
    in station.json under expected.summary, which the pages already read, and
    their definitions live in prose: both READMEs and docs/expected-vs-observed.md.
    That is the medium changing, not the publication -- anyone can read,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
2026-09-06 Publish the catalogue magnitude the catalogue currently gives
    The page showed Ontario at M3.4 while the USGS had settled on M3.2 four
    days earlier, so the one number published about the one earthquake found
    disagreed with the catalogue the whole method rests on.
    Two causes, both fixed. The public confirmed list is rebuilt from the
    journal, which is append-only by design and froze the preliminary M3.36 at
    first confirmation; refresh_confirmed_magnitudes already existed to
    reconcile the display, but only against the recent-catalogue block, so it
    stopped working the moment the event scrolled out of that window. It now
    consults the live findings as well. And the retrospective pass only re-read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
    [main.py, retro.py, usgs.py]
2026-09-06 Let a catalogue revision create or withdraw a confirmation
    A revision moves more than the magnitude. scan_quake reads the origin time,
    the distance and the depth to place the arrival window, and the magnitude to
    apply the amplitude veto, so a revised event can cross the threshold in
    either direction. The search only re-read events inside its 72 h lookback,
    which left two holes.
    An event filtered out by min_magnitude at the time and revised above it later
    was never scanned at all. The audit computes its own significance but takes
    "confirmed" from stored findings, so a real wavetrain sitting in the envelope
    would have been counted "missed": nobody having looked would have read as the
    station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
    [main.py, retro.py]
2026-09-07 Re-centre the published catalogue list on the public pin
    Withholding the station coordinates and dropping distance_km was not enough.
    The list of catalogued earthquakes drawn on the public map is everything
    inside radius_km of wherever it was queried from, so the list itself traces
    the edge of that disc: 98% of the catalogue inside the radius is listed and
    2 of 50 outside it are. Anyone can query the catalogue themselves, sort events
    into listed and absent, and fit the circle.
    Measured against the published history on 6 September, one week of it places
    the station within about 15 km, which is what the city-scale pin gives away
    anyway -- the gaps in the snapshot history are what limits it, s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
2026-09-07 Document the three ways a published field can leak the site
    Anyone publishing a station from their home hits these, and only the first is
    obvious. The per-event distance trilaterates it. The per-event detection
    probability is a monotone function of that distance, so it encodes the same
    thing. The list of catalogued earthquakes drawn on the map is the contents of a
    160 km disc and therefore traces its edge, which needs no field at all.
2026-09-08 Refresh the trigger and noise counts, drop a third placement caption
    One busy day moved both numbers by half: the journal is at 6488 triggers and
    the noise filter at 7129 samples against 4027 a week ago, still 0 earthquakes.
    The figures appeared in both READMEs, four docs and the paper.
    The panel caption about the node being an area was the third copy of the same
    sentence, after the legend and the popup.
2026-09-08 Measure the retro channel's false-confirmation rate on real envelope
    The 1-in-1200 figure came from simulated sensor noise, and both READMEs
    flagged it as optimistic pending a recomputation. Replaying the search at
    instants where no earthquake occurred -- 2781 control windows over five
    days -- reaches the threshold 22% of the time, tracking occupancy rather
    than sensor sensitivity.
    Amplitude is what separates the confirmation from that noise: the false
    confirmations peak at 10 mg (footsteps) where the 2 September event
    peaked at 1.095 mg, so requiring both leaves 1.87%, one in 53.
2026-09-09 Make the READMEs readable without prior knowledge, and state why a confirmation cannot train the model
    Define catalog and control where they are first used, and rewrite STA/LTA, z
    and the envelope in terms a reader can check.
    The two files said confirmations were excluded from the amplitude model by
    retro.feed_calibration: false. That key is read at startup and never used
    again: no code path in the retrospective loop adds a calibration point, so the
    separation is structural. Give the three reasons instead — selection bias on
    the amplitude, a distance that comes from the same catalog as the target
    magnitude and that locates the window it is read from, and a peak over 0.5 s
    against a mean o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
2026-09-09 Record the false confirmation and the withdrawn miss
    The retrospective channel crossed its threshold a second time, on ci41543136
    (M2.33, 8 Sep evening). It cannot be real: the frozen law puts the expected
    shaking 33x below the sensor's own noise floor, the recorded peak is 103x the
    prediction and so passed the 146x amplitude veto, and replaying from the public
    pin returns z = 3.29 instead of 4.02. It is the first real instance of the
    1-in-54 rate measured a day earlier, so the public counter now reads 2 confirmed
    where only one is genuine, and both pages say so.
    Separately, USGS revised ci41542024 to M3.07 and relocated it deeper, which
    dropped the pessimistic detection probability under 0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
    [eventlog.py]
2026-09-09 Restore the station snapshot dropped by a force-push
    The previous push rebuilt main from a commit that predated the 02:01 UTC
    snapshot, so the board publish was lost. Content restored as-is; the board
    republishes through the contents API and never force-pushes, so history is
    left alone rather than rewritten.
2026-09-09 Show a confirmation on the map when its line is clicked
    The line was a link to USGS, which answered the wrong question first: the map is
    where distance is read. It is now a button that flies to the earthquake and
    opens its popup, with a separate small USGS link beside it for checking the
    magnitude against the source.
    The marker usually exists already, drawn from the live catalogue for the window
    the slider is on. It can be absent, because the panel lists every confirmation
    ever while the map only draws the current window. In that case the event is
    fetched by id and drawn on its own layer, and the popup says it is older than
    the window rather than pretending the slider covers it. Both paths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
2026-09-09 Recompute the false-confirmation rate on complete envelope days
    Two of the five control days had been copied off the board before the UTC
    day ended: 6 September held 32% of its day, 5 September 83%. Re-fetched
    complete, every day now yields the same 718 windows.
    control windows 2 980 -> 3 585
    significance only 21.2% -> 17.9% (1 in 5 -> 1 in 6)
    with the amplitude condition 1.85% -> 1.81% (1 in 54 -> 1 in 55)
    The conclusion is unchanged, which is what the check was for. The public
    counter caveat, both READMEs and the contest notes follow.
2026-09-09 Retitle the report around the $12 sensor, not the node
    The old title priced the whole node ($80). Naming the motion sensor is
    clearer and matches the report own framing, but 11.80 $ buys only the
    LSM6DSOX module, so the abstract now states both prices and the citation
    blocks follow. Also drop the stale claim that an English translation is
    still to come, and align the Zenodo date with .zenodo.json.
2026-09-09 Lead the contest material on what the measurement makes possible
    Measuring that 96.9% of the catalog is out of reach is not a negative
    result: it is the first sensitivity figure for this hardware, and it is what
    a network has to be sized on. Both the storyboard and the submission
    checklist now carry the fifty-node case with its reservation, and close on
    the deposited report rather than on a promise.
    Three stale claims fixed while there. The negative control is six cataloged
    events examined and four refused, not three and two. Neither public page has
    qualified the false confirmation since the caveats were removed, so the
    Story and the voice-over have to make that distinction themselves. And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
2026-09-09 Align the site subtitle with the report title
    The header still described an $80 Arduino node while the report now leads on
    the $12 sensor, so a visitor clicking through to the paper met two framings.
    Both prices are named, because a bare "$12 station" would be exactly the
    overstatement the project refuses, and "proved wrong" says what the report
    calls falsifiable without the word.
2026-09-12 Add sober confirmed-only map filter and optional confirmation clips.
    Align the public confirmed list with live retro findings; link the Inglewood TikTok discreetly on the map and data pages.
2026-09-28 Record the Hermosa Beach confirmation in both READMEs.
    The status was still 23 September, with four retained crossings. This fifth one, at z = 22, does not move the calibration.
2026-10-04 Show the node's hardware and its sensor temperature, and keep the day slider usable.
